University-of-Nottingham-EEE-Projects/Picotar/Picotar Schematic.pdf

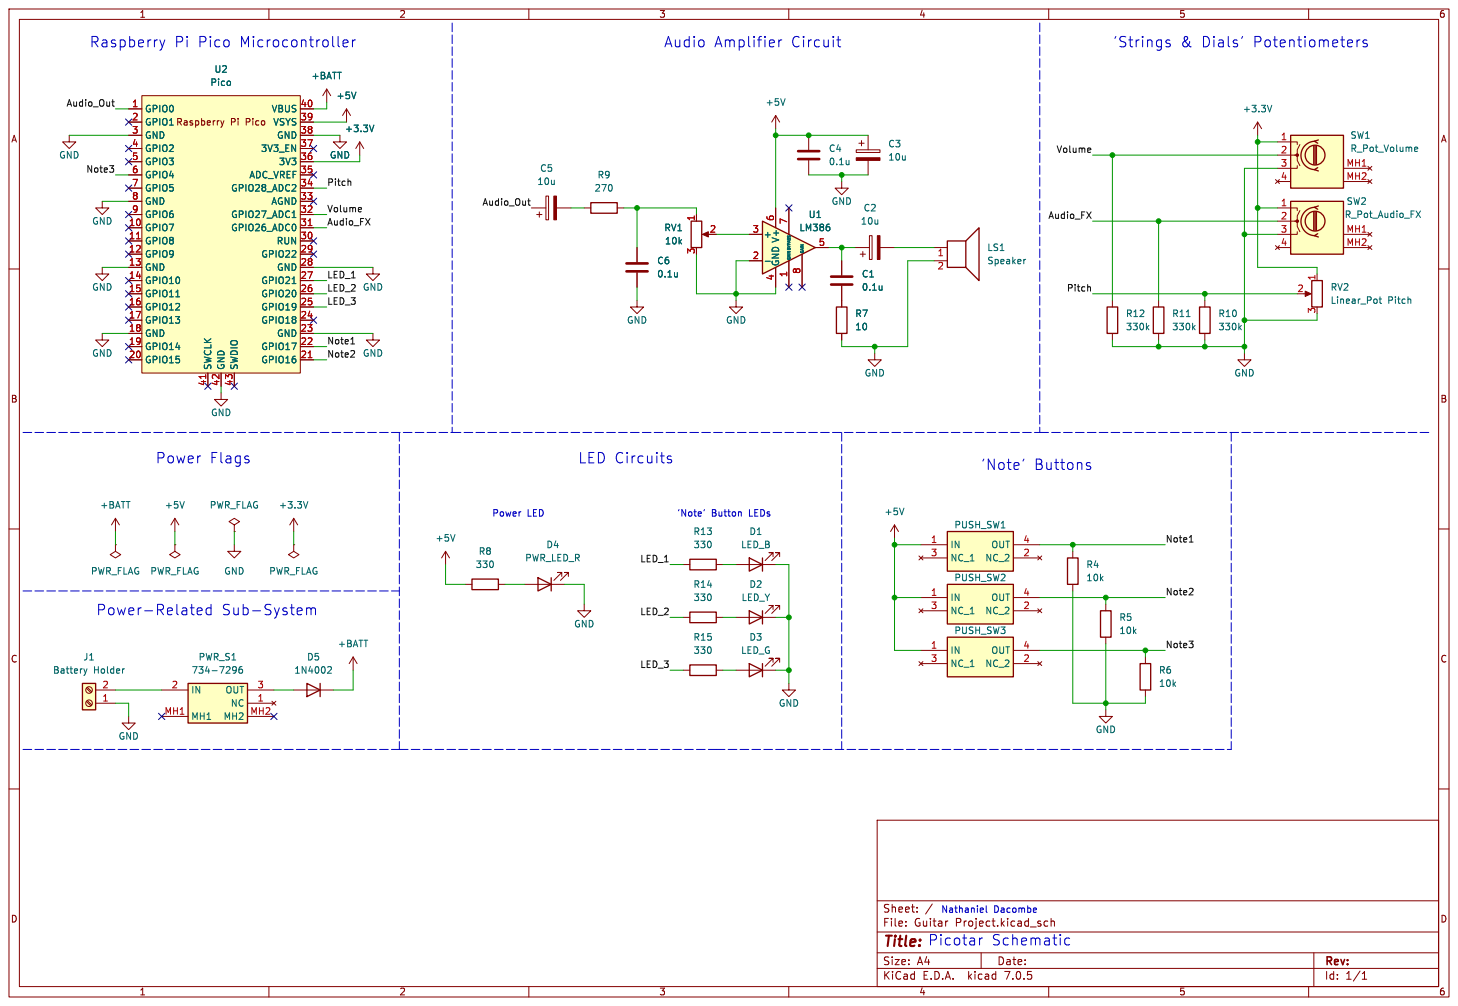
[picture p33: page 1]

Raspberry Pi Pico Microcontroller

'Note' Buttons LED Circuits
